Lorenzozero/monster_sync_app/docs/assets/cruscotto-screenshot.jpg

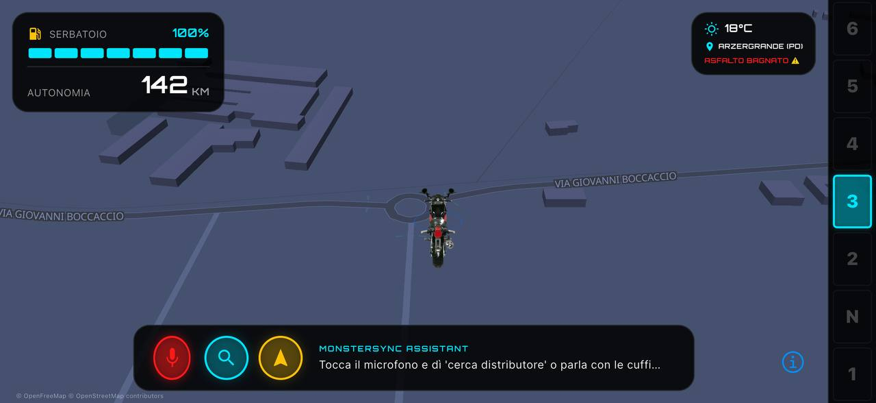
docs/assets/cruscotto-screenshot.jpg
