Lorenzozero/monster_sync_app/(commit log)

2026-08-29 Initial open-source release with GSAP 3D landing page
2026-08-29 Fix Android notification icon path, add hardware specs and iOS/IPA build guides to landing page and README
2026-08-29 Enhance landing page with glassmorphic cards, detailed hardware section, compilation guide, and scroll-synchronized hotspot visibility fades
2026-08-29 Optimize model-viewer with AR support, high-performance rendering preference, and centered camera rotation target
2026-08-29 Implement full-screen splash loader with diagnostic checks, glowing interactive start button, and Web Audio API synthesized desmodromic engine roar
2026-08-29 Fix model-viewer height to h-full and remove camera-target to prevent cropping, and adjust hotspot 3D coordinates
2026-08-29 Update landing layout to full-screen 3D model-viewer behind text blocks, apply metallic dark red background gradient, and use pointer-events delegation for background interactivity
2026-08-29 Add navbar hide-on-scroll, AliExpress pricing table, monitored parameters section, mobile app preview mockup, and scroll-responsive 3D lean and wheelie animations
2026-08-29 Fix landing page audio by removing scroll event from gesture list and checking engineRoarPlayed before removing listeners, and bump script to v5
2026-08-29 Add loading screen audio unlock button, optimize transition delay at 100% progress, and bump script cache buster version to v6
2026-08-29 Expose native areNotificationsEnabled in NotificationService, use PNG icon for notifications, and make test buttons always enabled in LibrettoView
2026-08-29 Add Fuel Control and Range Estimate parameters to the landing page data logger grid
2026-08-29 Update AliExpress table component utilization descriptions to document fuel reserve and gear logic
2026-08-29 Update GPS parameter description on landing page to explicitly highlight live GPS tracking on offline maps
2026-08-29 Add dedicated Smart Vehicle Finder section in mockup preview on landing page
2026-08-29 Update README.md with Vercel deployment guidelines and detailed software-powered features (fuel range, live gears, parking finder)
2026-08-29 Simplify README.md by replacing Vercel guide with direct link to deployed landing page
2026-08-29 Add compiled release APK to docs and link the landing page download button directly to it
2026-08-30 Feat: aggiunta cruscotto landscape ad attivazione long press logo con vibrazione, flash, ruggito motore, mappe offline e assistente vocale
2026-08-30 Fix & Refactor: ottimizzazioni mobile per il modello 3D, mockup iPhone rotante in landscape e permessi iOS
2026-08-30 Fix: ottimizzato lo scorrimento e la scomparsa della tabella e del 3D e la comparsa ritardata delle sezioni mockup/download
2026-08-30 Fix: ridotta la durata della dissolvenza della tabella per farla sparire ancora prima nello scorrimento
2026-08-30 Fix: aggiunto spacer fisico e separata la transizione di sparizione della tabella in GSAP per eliminare ogni sovrapposizione con il mockup
2026-08-30 Optimize landing page load performance: compress 3D GLB model to 7.22MB and use lazy loading with Draco decoder
2026-08-30 Optimize dashboard: add quick Waze navigation, 3D motorcycle marker, simplified weather bar, detailed rain alert, compact Libretto update button and fix notifications invalid_icon crash
2026-08-30 Optimize dashboard: vertical right gear bar (6 to 1), Siri rotating 3D microphone, responsive sync button with opaque hit-testing, relocated weather chip, and swipe close gesture
2026-08-30 feat: firmware nel repo, dati del libretto nel DB, moto 3D sulla mappa
    Privacy: targa, telaio, intestatario e data di immatricolazione erano
    hardcoded in libretto_view.dart su un repository pubblico. Ora vivono
    nella tabella SQLite vehicle_identity (DB v3, con migrazione) e si
    compilano da un dialog in-app; il sorgente contiene solo segnaposto.
    Firmware: aggiunta la cartella firmware/ con lo sketch ESP32 (FreeRTOS,
    BLE GATT, GPS NMEA, ingressi optoisolati) e la sezione README con
    ambiente, mappa dei pin, procedura di flash, nota sul Wi-Fi che affama
    l'antenna BLE e sette regole di sicurezza elettrica per il montaggio.
    Mappa: l'indicatore di posizione usa il modello 3D della moto invece
    del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
2026-08-30 feat(firmware): driver MPU-6050 reale, zip pronto da flashare, APK fuori dal repo
    IMU: implementato il driver I2C dell'MPU-6050 (WHO_AM_I, DLPF a 21 Hz per le
    vibrazioni del bicilindrico, +/-500 dps, +/-4 g, calibrazione del bias del
    giroscopio su 500 campioni all'avvio). IMU_Init() non e' piu' un TODO.
    Due bug corretti nel modulo esistente:
    - DT era una costante di 2 ms (500 Hz) mentre il task gira a 100 Hz: il
    giroscopio veniva integrato 5 volte piu' piano del dovuto. Ora dt e' misurato
    con micros().
    - IMU_GetLeanAngle() restituiva RADIANTI ma l'app legge il campo come gradi
    (le soglie della heatmap sono 15 e 30): ora converte.
    Aggiunti l'allineamento statico da accelerometro sotto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
    [imu_kinematic.cpp, imu_kinematic.h]
2026-08-30 docs: BOM corretta prima dell'ordine
    - Scheda: ESP32-S3, non WROOM-32D (firmware e pin sono tarati sull'S3).
    - GPS BN-220: esce a 9600 baud e 1 Hz, il firmware vuole 115200 e 10 Hz.
    Va configurato una volta con u-center, riducendo le frasi NMEA attive.
    - Aggiunti i 1N4148 in antiparallelo agli opto sull'iniettore.
    - Alimentazione: LM5164 automotive, oppure LM2596 con TVS SMAJ33A e MOSFET
    anti-inversione. L'LM2596 nudo regge 40 V e nessun load dump.
    - Aggiunta la voce cablaggio/minuteria e il supporto smorzante per l'IMU.
    - Totale realistico 50-60 EUR, non 22.
2026-08-30 docs(landing): tabella componenti aggiornata con la BOM corretta
    Da 6 voci / 22,30 EUR a 10 voci / ~55 EUR.
    - ESP32-S3 al posto del NodeMCU WROOM-32D
    - BN-220 con l'avvertenza sui 9600 baud / 1 Hz di fabbrica
    - nuove righe: diodi 1N4148, buck automotive LM5164, TVS + MOSFET,
    cablaggio e minuteria, supporto antivibrante per l'IMU
    - riquadro opzionali: ICM-42688-P, partitore per la tensione batteria,
    NTC (o il tap sul sensore testa gia' presente sulla moto)
    - i vincoli critici sono evidenziati in rosso nella colonna Utilizzo
    - nota esplicita che i link sono ricerche, non prodotti singoli
2026-08-30 fix(notifiche): icona drawable, e cruscotto ripulito
    Notifiche: init e invio tornavano a usare '@mipmap/ic_launcher', che il
    plugin non trova perche' risolve l'icona con getIdentifier(name,"drawable")
    e guarda SOLO in res/drawable-*. Il file esiste in res/mipmap-* ma non conta:
    da qui PlatformException(invalid_icon). Ora si usa 'ic_notification', PNG
    presente in tutte le densita' drawable, senza prefisso. Tolto anche il
    "fallback" che riprovava con la stessa risorsa fallita.
    Cruscotto landscape:
    - rimosso l'indicatore di marcia dal pannello sinistro: e' gia' sulla barra
    verticale a destra
    - comune e avviso pioggia spostati sotto i gradi nel chip meteo in basso a
    destra, cosi' il meteo s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
2026-08-30 fix(android): keep.xml per l'icona notifica, mappa scura vera, serbatoio in alto a dx
    Notifiche, causa vera: il resource shrinker di R8 eliminava ic_notification
    perche' e' referenziata solo da una stringa a runtime. In debug non si vede
    (lo shrinker non gira), in release l'icona sparisce dall'APK. Prova in
    build/app/outputs/mapping/release/resources.txt:
    "drawable:ic_notification:... is not reachable."
    Aggiunto res/raw/keep.xml con tools:keep. Ora il report dice
    "reachable from keep xml file" e il nome e' nella resources.arsc.
    Mappa: si usavano le tile CHIARE di OSM con una ColorFilter.matrix di
    inversione — da cui il viola e le strade illeggibili. Sostituite con CartoDB
    Dark Matter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
2026-08-30 feat(libretto): via i pulsanti TEST, dentro le cinghie di distribuzione
    Rimossi i due pulsanti TEST delle notifiche (manutenzioni e scadenze legali)
    ora che le notifiche funzionano, insieme ai tre metodi rimasti orfani.
    Aggiunta la voce CINGHIE DI DISTRIBUZIONE: mancava, ed e' l'intervento piu'
    importante di un Desmodue. Scade nel tempo prima che nei km, e se cede il
    motore e' da rifare.
    Corretta la nota del gioco valvole: diceva "no Desmo", ma la Monster 695 e'
    esattamente un Desmodue — 2 valvole per cilindro a comando desmodromico,
    senza molle di richiamo. Per questo la registrazione va fatta in officina
    specializzata.
2026-08-30 fix(mappa): tema scuro senza API key, riquadro carburante unico, moto piu' grande
    CartoDB Dark Matter ora pretende una API key: senza chiave serviva tile con
    la scritta "API KEY REQUIRED" stampata sopra. Tornato a OpenStreetMap con
    inversione PIU' rotazione di tinta di 180 gradi: la sola inversione (com'era
    all'inizio) ribalta anche la tinta e fa diventare tutto viola, la rotazione
    di tinta rimette ogni colore al suo posto. Tema notturno vero, zero chiavi.
    Serbatoio e autonomia uniti in un solo riquadro nell'angolo in alto a
    sinistra; eliminato il pannello in basso a sinistra.
    Marker moto: da 90 a 130 px, modello da 70 a 110, allineato al centro sul
    punto GPS, rotate:true per restare orien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
2026-08-30 feat: termocoppia e partitore in lista principale, meteo in alto a destra
    BOM: termocoppia tipo K con anello sotto candela + MAX31855 e partitore
    100k/18k passano da "opzionali" a componenti della lista. Motivazioni nel
    README: la testa e' il parametro che anticipa i guai su un motore ad aria e
    l'anello non richiede modifiche meccaniche ne' tocca la centralina; il
    partitore fa vedere il regolatore che cede prima di restare a piedi.
    Totale aggiornato da ~55 a ~75 EUR, qui e nella tabella della landing.
    Corretta la descrizione della funzione allarme: parlava di olio a 115 gradi,
    ma il sensore misura la testa — soglie completamente diverse, e comunque da
    ricavare registrando qualche giro inv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
2026-08-30 feat: motore pace notes + meteo con condizione dell'asfalto
    pace_notes.dart — da una traccia GPS produce le note del copilota:
    "tra 250 metri, destra 3, si stringe". Ricampionamento a 5 m, curvatura di
    Menger con segno, classificazione in scala rally 1-6, raggruppamento in curve
    con andamento (si stringe / si apre) e distanza di avvicinamento.
    Due scelte non ovvie, entrambe dettate dalle misure:
    - la curvatura si calcola a DUE scale e la scala si sceglie PER CURVA, non
    punto per punto. Base corta per i tornanti, base lunga per i curvoni: con
    raggio 200 m la freccia su 30 m di base e' mezzo metro, meno del rumore
    del GPS, e la base corta misurerebbe solo rumore. Su un tornante vale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
2026-08-30 chore: rimuove il filtro mediano, sostituito dalla scelta di scala per curva
2026-08-30 feat: schermata pace notes e meteo reale nel cruscotto
    - Nuova PaceNotesView: apre un GPX, ne ricava le note del copilota e le
    mostra in lista con severita' colorata, raggio, sviluppo, distanza e
    velocita' di riferimento. Si raggiunge dall'icona percorso nella tab Mappa.
    - Le velocita' di riferimento sono gia' derattate dal meteo: se ha piovuto
    nelle ultime ore scendono, e il banner in testa dice di quanto e perche'.
    - Il widget meteo del cruscotto non e' piu' hardcoded: legge Open-Meteo e
    mostra i gradi veri e la CONDIZIONE DELL'ASFALTO, che in moto e'
    l'informazione utile, molto piu' della temperatura.
    - Aggiunta dipendenza file_picker per aprire il GPX.
    - Rimosso test/widget_tes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
2026-08-30 fix(build): niente file_picker, i GPX si leggono dalla cartella dell'app
    file_picker non si riesce a integrare in questo progetto: la 8.x fissa
    compileSdk 34 nel proprio build.gradle e va in conflitto con
    flutter_plugin_android_lifecycle che ne pretende 36; la 11.x risolve quello
    ma lascia un GeneratedPluginRegistrant che referenzia una classe Java non
    piu' esistente, e il clean non basta. Tre build fallite: la dipendenza non
    vale il prezzo per un pulsante.
    Sostituita con una scansione della cartella dell'app (path_provider, gia'
    presente): l'utente copia i GPX in Android/data/<pkg>/files e la schermata
    li elenca. Nessun permesso di accesso alla memoria, nessuna dipendenza nuova.
    Ripristina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
2026-08-30 feat(nav): OsmAnd come navigatore primario, offline e con limiti
    Catena di scelta in NavigationService: OsmAnd > Waze > mappa interna.
    OsmAnd calcola il percorso OFFLINE, ha i limiti di velocita' da OSM e gli
    avvisi autovelox: in montagna senza campo e' l'unica che continua a
    funzionare. Waze resta per quando c'e' rete, perche' ha il traffico in tempo
    reale che OsmAnd non puo' avere. La mappa interna e' l'ultimo fallback.
    Corretto un bug latente: nel manifest mancavano le <queries> per lo schema
    "waze", e da Android 11 canLaunchUrl risponde false per qualunque schema non
    dichiarato. Il deep link a Waze quindi non ha MAI aperto l'app: cadeva
    sempre sul link web. Aggiunte le query per waze, g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
2026-08-30 docs(landing): sezione Copilota — pace notes, meteo e navigazione offline
    La landing si era fermata alla BOM: mancavano le tre funzioni nate dopo.
    Nuova sezione "05 / IL COPILOTA" con:
    - le pace notes da un GPX, e il motivo per cui la scala di misura della
    curvatura si sceglie per curva e non per punto
    - la precisione misurata, riportata com'e': 100% sulle curve strette, ~80%
    sui curvoni, e il limite dichiarato invece che nascosto
    - il meteo che legge le sei ore precedenti di pioggia e abbassa le velocita'
    di riferimento
    - OsmAnd come navigatore offline, con Waze quando c'e' rete
    - una nota di onesta' sui limiti: la traccia registrata e' la tua traiettoria,
    non la strada, e le note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
2026-09-03 wip(cruscotto): impalcatura per la navigazione interna
    Campi di stato per la navigazione sulla mappa dell'app: rotta attiva, indice
    del punto corrente, timer di avanzamento, prossima svolta, distanza alla
    svolta, ETA, distanza residua, destinazione scelta e rotazione mappa.
    _myLocation diventa modificabile per poter avanzare lungo la rotta.
    Al momento sono solo dichiarazioni: la logica arriva nel commit successivo.
2026-09-03 feat(cruscotto): ricerca destinazione e navigazione sulla mappa dell'app
    Riempie l'impalcatura del commit precedente.
    Nuovo geocoding_service.dart, tutto su servizi aperti senza chiave:
    - Nominatim (OpenStreetMap) per cercare la destinazione per nome, con i
    risultati ordinati per vicinanza alla posizione attuale
    - OSRM per il percorso stradale vero e le manovre, tradotte in italiano
    ("Gira a destra", "Alla rotonda...", "A fine strada gira a sinistra")
    - senza rete ricade sulla linea retta, ma lo DICHIARA invece di fingere un
    percorso: straightLineFallback
    Cruscotto:
    - pulsante di ricerca (lente) accanto al microfono: apre una scheda con
    campo di testo e risultati, e alla scelta cal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
2026-09-03 ci: codemagic.yaml per l'IPA non firmato
    Pipeline iOS senza Mac e senza account Apple Developer a pagamento, ricalcata
    sulla procedura gia' collaudata su SickFitPro. I quattro punti che contano,
    ognuno nato da un errore vero:
    - Swift Package Manager disattivato PRIMA di tutto: quando e' attivo puo'
    linkare due volte le stesse dipendenze e la build muore con centinaia di
    "duplicate symbols".
    - Podfile generato se manca: questo progetto ha la cartella ios/ ma non e'
    mai stato compilato per iOS, quindi il Podfile non esiste ancora.
    - pod install come passo A SE': dentro il wrapper di Flutter l'errore vero
    viene inghiottito e resta solo "Error running pod install", che non dice
    niente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
2026-09-04 feat(cruscotto): vista in prima persona, mappa satellitare, costo dei giri
    Il cruscotto guardava la strada dall'alto come una cartina. Ora la guarda
    dalla sella.
    VISTA IN PROSPETTIVA
    flutter_map non sa cosa sia l'inclinazione della camera: si ottiene
    deformando il widget con una matrice di prospettiva. I numeri sono
    misurati, non a occhio — la scena e' stata prima montata in CSS con le
    stesse tile e le stesse proporzioni dello schermo:
    - 54 gradi con il fuoco a 625 px mandano l'orizzonte 454 px sopra il
    centro, fuori dal riquadro: niente cielo da disegnare, nessun bordo
    scoperto;
    - il piano della mappa dev'essere largo il doppio e alto 3,6 volte lo
    schermo, o la prospettiv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
2026-09-04 feat(cruscotto): camera in prima persona, autovelox, indicatore di cambiata
    CAMERA PIU' BASSA
    Da 54 a 62 gradi di inclinazione, zoom da 17 a 18: la strada davanti si
    legge, non si indovina. A 62 gradi pero' la compressione prospettica
    esplode — per riempire anche l'ultima striscia in alto servirebbe un piano
    alto quindici volte lo schermo, centocinquanta tile da scaricare per un
    dito di immagine. Il piano si ferma a 2,6 volte e sopra il suo bordo va una
    foschia, che e' anche quello che vedresti davvero guardando lontano. Il
    punto dove finisce la mappa lo calcola la stessa formula della matrice,
    quindi la fascia si adatta da sola a qualunque schermo.
    Il piano e' anche piu' stretto e senza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
2026-09-05 feat(cruscotto): una sola vista, e la moto guarda la strada da dove la guardi tu
    Via i due pulsanti dei comandi vista: ciclavano tre stili di mappa e
    spegnevano il 3D, quattro combinazioni da decidere mentre guidi. In moto una
    scelta da fare e' una scelta di troppo. Resta il satellite inclinato, e il
    lato sinistro dello schermo torna pulito.
    Gli altri due stili spariscono anche dal codice invece di restare li' come
    rami morti: map_styles.dart ha una sola costante e non ha piu' bisogno ne'
    di material ne' del filtro colore.
    L'ANGOLO DELLA MOTO
    Il modello era inquadrato a 22 gradi dalla verticale — quasi a piombo —
    appoggiato su un asfalto inclinato di 62. Due punti di vista diversi nell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
2026-09-05 feat(cruscotto): cartografia chiara al posto della foto aerea, camera a 66 gradi
    Sulla fotografia aerea l'asfalto e il tetto di un capannone hanno lo stesso
    grigio, e a 90 all'ora quel grigio non ti dice dove svoltare. Una carta
    disegnata traccia le strade in bianco, le separa dal costruito e ci scrive
    sopra i nomi. La vista resta inclinata: cambia cosa c'e' sotto, non come la
    guardi.
    QUALE CARTA — provate tutte a schermo inclinato
    - Esri World Street Map: pulita, ma a zoom 19 si svuota. Resta una strada su
    un campo beige, senza edifici: in citta' non dice piu' niente.
    - Esri Light Gray Canvas: da zoom 18 in su risponde "Map data not yet
    available". Non ha tile a quel dettaglio.
    - OSM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
2026-09-05 feat(navigazione): si sceglie fra piu percorsi, con costo, autovelox e curve
    Prima si partiva sull'unico percorso che tornava OSRM, senza vederlo. Ora
    la ricerca di una destinazione apre un confronto e la scelta e' tua.
    VIA OSRM, DENTRO VALHALLA
    Il server pubblico di OSRM **non sa dare alternative**: e' compilato con
    Contraction Hierarchies e con quell'algoritmo il parametro `alternatives`
    viene ignorato — chiesto o no, torna sempre una rotta sola. Verificato su
    due tragitti diversi prima di cambiare.
    Valhalla di FOSSGIS le da', ed e' meglio su altre tre cose: ha un profilo
    **motorcycle** vero, manda le istruzioni **gia' in italiano** (sparisce la
    tabella di traduzione scritta a mano), e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
2026-09-05 feat(navigazione): miniatura del percorso nella scelta, ed esplorazione col dito
    MINIATURA NELLA SCELTA
    Ogni alternativa porta il suo tragitto visto dall'alto, in un francobollo di
    108x78: mappa inquadrata sui limiti del percorso, linea blu, pallino bianco
    alla partenza e rosso all'arrivo. I numeri dicono quanto ci metti e quanto
    costa, non **dove passa** — e due tragitti da due ore possono girare da
    parti opposte della montagna.
    ESPLORAZIONE COL DITO
    La mappa era bloccata (InteractiveFlag.none). Ora si trascina e si pizzica,
    ma **non si ruota**: l'orientamento lo decide la rotta di marcia, girarla a
    mano vorrebbe dire perdere il "in alto c'e' dove stai andando", che e' tutto
    il senso di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
2026-09-10 fix(landing): correggi BOM pubblica, LM2596 al posto di LM5164, via termocoppia
    L'LM5164 non esiste come modulo pronto: costa di piu' a pezzo singolo e
    richiede un layout switching disegnato da zero, piu' rischio nella
    costruzione hobbistica del chip stesso. LM2596 + TVS SMAJ33A + AO3401
    (gia' verificati) sono la combinazione approvata via via decisa per la
    BOM reale. Rimossa la termocoppia K + MAX31855 (18 EUR): duplicava
    l'NTC di serie che la 695 ha gia' sulla testa, leggibile gratis con un
    buffer ad alta impedenza. Totale stimato aggiornato da ~75 a ~46 EUR.
2026-09-10 fix(landing): tabella BOM in griglia a 2 colonne senza scroll interno
    Porting del fix gia' pushato su mobile (d0a0966): la lista componenti
    scorreva verticalmente dentro il box, tagliando le righe finali fuori
    dalla vista. Convertita da <table> a card in griglia 2 colonne
    (nome+prezzo, descrizione, link), altezza dimezzata.
2026-09-10 fix(landing): tabella hardware non scorre più internamente, click preciso
    Porting del fix gia' pushato su mobile (322e061): overflow-y-auto sul
    modal si confondeva con lo scroll-scrub della pagina; aggiunta una pausa
    reale (label "hardwareVisible") tra fade-in e fade-out della tabella;
    il link HARDWARE del menu ora scrolla esattamente a quel punto invece
    di saltare al bordo della sezione placeholder.
2026-09-10 fix(landing): sposta TRE NOTE nella colonna sinistra, la tabella non ci stava
    Porting del fix gia' pushato su mobile (8bc89f4): il box TRE NOTE in
    fondo alla colonna destra allungava quella colonna oltre l'altezza del
    modal. Spostato sotto la citazione nella colonna sinistra, che aveva
    spazio vuoto.
2026-09-10 fix(landing): screenshot reale del cruscotto al posto del mockup illustrato
    Porting del fix gia' pushato su mobile (6da12b5): la vista landscape del
    telefono mockup era interamente disegnata a mano, ora mostra uno
    screenshot reale dell'app in modalita' cruscotto.
2026-09-10 fix(landing): nasconde il notch del mockup in modalita' landscape
    Porting del fix gia' pushato su mobile (3f44f9d): il notch ruota col
    telefono e in landscape copriva la colonna marce dello screenshot reale.
2026-09-10 fix(landing): centra davvero il mockup landscape, via percentuali non pixel
    Porting del fix gia' pushato su mobile (cd50e3c): top/left in pixel
    scelti a mano lasciavano 8px di scarto verticale (locale) che nel verso
    finale della rotazione diventava spazio vuoto orizzontale visibile.
    Sostituito con centratura via percentuali + translate, esatta per
    costruzione.
2026-09-10 perf(landing): tolto Tailwind CDN JIT, aggiunto favicon, script deferred
    Porting del fix gia' pushato su mobile (21bf188): CSS Tailwind
    precompilato al posto del CDN JIT (stesso output, zero ricompilazione
    runtime), favicon.svg aggiunto, script GSAP/ScrollTrigger/app.js con
    defer. Nessuna modifica visiva.
