Lorenzozero/monster_sync_app/(notices)

Notices in the files:
README.md:
License: MIT
